TomWhitwell/8mu_Public/Firmware_v2/README.md

## Firmware v2 

Devices bought after August 2026 are v2. They have v2 clearly marked next to the USB socket, and have a RP2040 chip. 

Firmware for v2 will be shared here.
