TomWhitwell/8mu_Public/Hardware/8mu_pub.brd

## EAGLE design Hardware/8mu_pub.brd (2022-12-14, last stored version)

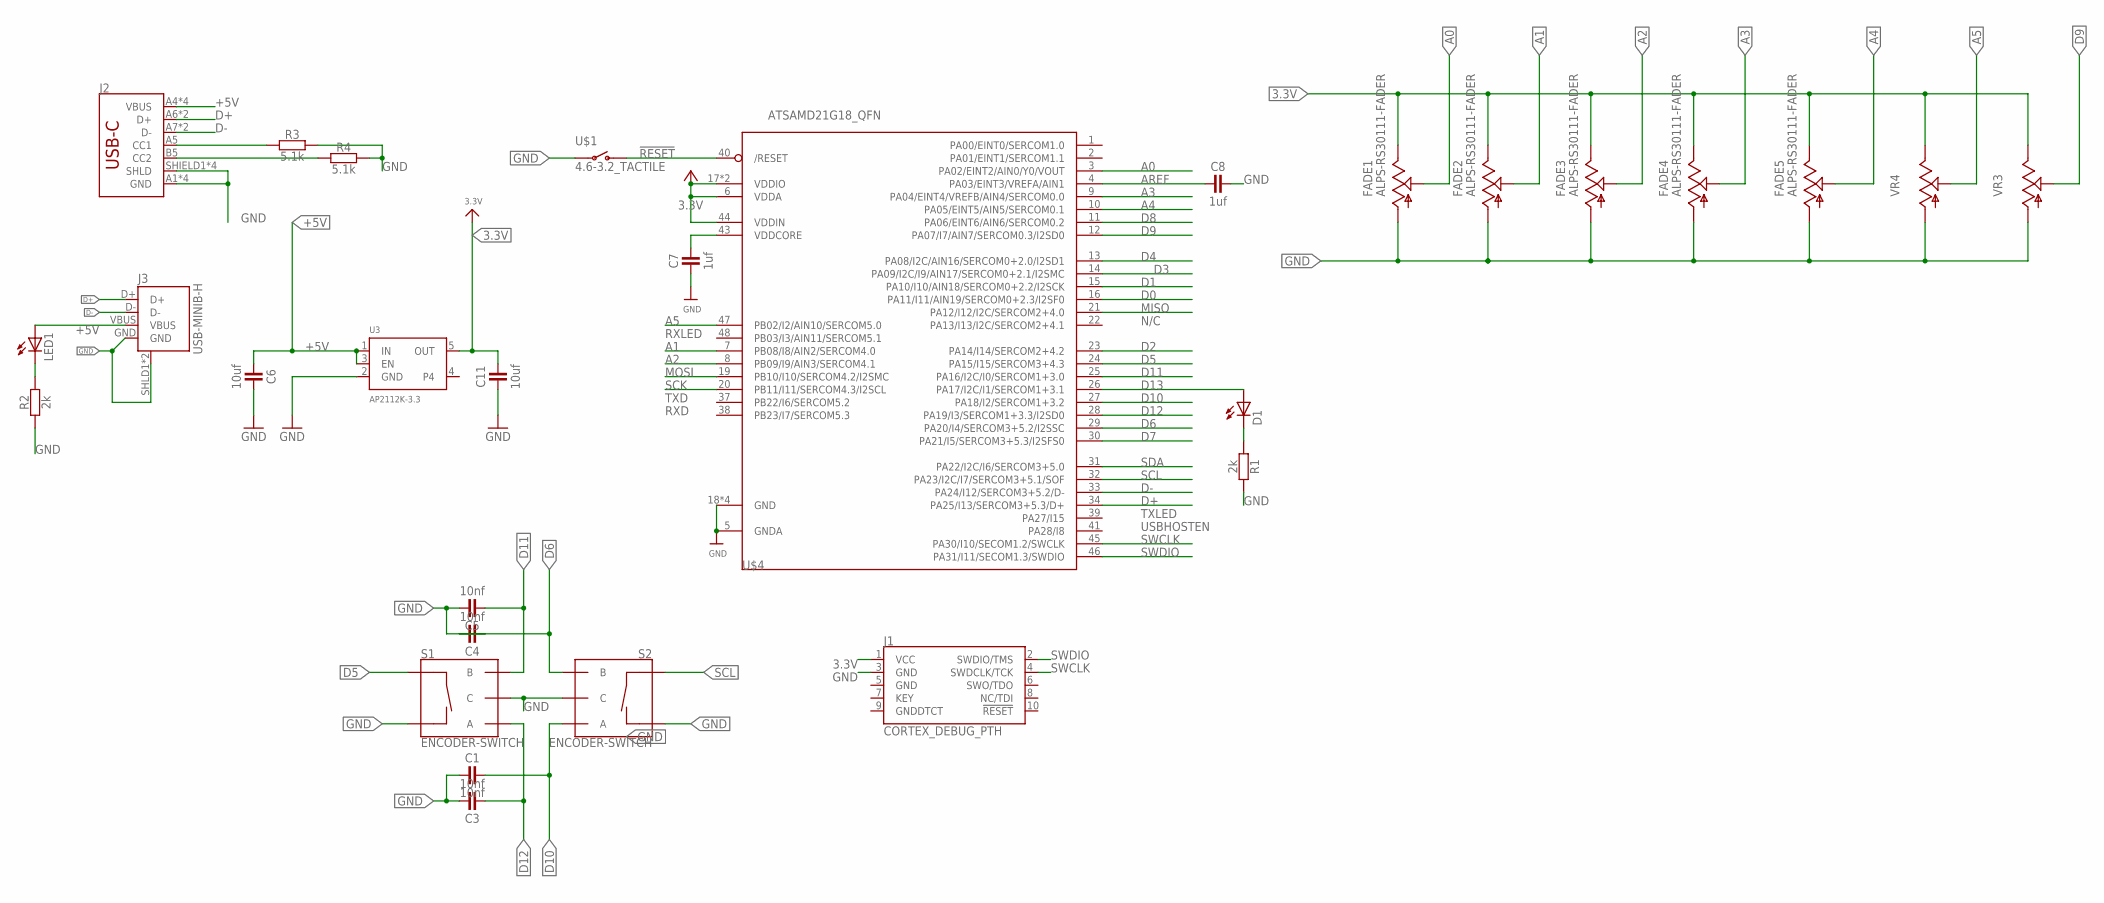
[picture p1: schematic 8mu_pub.sch]

Parts:
C1, C3, C4, C5: 10nf; C0603
C6, C11: 10uf; C0603
C7, C8: 1uf; C0603
D1: LED3MM
FADE1, FADE2, FADE3, FADE4, FADE5: ALPS-RS30111-FADER
J1: CORTEX_DEBUG_PTH; 2X5-PTH-1.27MM
J2: USB_C; CX90M-16P-USB-C-MIDMOUNT
J3: USB-MINIB-H
LED1: LED3MM
R1, R2: 2k; C0603
R3, R4: 5.1k; C0603
S1, S2: ENCODER-SWITCH; ROTARY_ENC_PLAIN
U3: AP2112K-3.3; SOT23-5
U$1: 4.6-3.2_TACTILE; TACTILE_SWITCH_SMD_4.6X2.8MM
U$4: ATSAMD21G18_QFN; TQFN48_7MM
VR3, VR4: 9MM_SNAP-IN_POT_; 9MM_SNAP-IN_POT

Connections:
3.3V: C11.2, FADE1.3 (E), FADE2.3 (E), FADE3.3 (E), FADE4.3 (E), FADE5.3 (E), J1.1 (VCC), U3.5 (OUT), U$4.6 (VDDA), U$4.17 (VDDIO), U$4.36 (VDDIO), U$4.44 (VDDIN), VR3.3 (E), VR4.3 (E)
!RESET: U$1.3 (O), U$1.4 (O), U$4.40 (/RESET)
+5V: C6.1, J2.A4 (VBUS), J2.A9 (VBUS), J2.B4 (VBUS), J2.B9 (VBUS), J3.VBUS, LED1.A, U3.1 (IN), U3.3 (EN)
A0: FADE1.2 (S), U$4.3 (PA02/EINT2/AIN0/Y0/VOUT)
A1: FADE2.2 (S), U$4.7 (PB08/I8/AIN2/SERCOM4.0)
A2: FADE3.2 (S), U$4.8 (PB09/I9/AIN3/SERCOM4.1)
A3: FADE4.2 (S), U$4.9 (PA04/EINT4/VREFB/AIN4/SERCOM0.0)
A4: FADE5.2 (S), U$4.10 (PA05/EINT5/AIN5/SERCOM0.1)
A5: U$4.47 (PB02/I2/AIN10/SERCOM5.0), VR4.2 (S)
AREF: C8.1, U$4.4 (PA03/EINT3/VREFA/AIN1)
D0: U$4.16 (PA11/I11/AIN19/SERCOM0+2.3/I2SF0)
D1: U$4.15 (PA10/I10/AIN18/SERCOM0+2.2/I2SCK)
D2: U$4.23 (PA14/I14/SERCOM2+4.2)
D3: U$4.14 (PA09/I2C/I9/AIN17/SERCOM0+2.1/I2SMC)
D4: U$4.13 (PA08/I2C/AIN16/SERCOM0+2.0/I2SD1)
D5: S1.SW+, U$4.24 (PA15/I15/SERCOM3+4.3)
D6: C4.2, S2.B, U$4.29 (PA20/I4/SERCOM3+5.2/I2SSC)
D7: U$4.30 (PA21/I5/SERCOM3+5.3/I2SFS0)
D8: U$4.11 (PA06/EINT6/AIN6/SERCOM0.2)
D9: U$4.12 (PA07/I7/AIN7/SERCOM0.3/I2SD0), VR3.2 (S)
D10: C1.2, S2.A, U$4.27 (PA18/I2/SERCOM1+3.2)
D11: C5.1, S1.B, U$4.25 (PA16/I2C/I0/SERCOM1+3.0)
D12: C3.1, S1.A, U$4.28 (PA19/I3/SERCOM1+3.3/I2SD0)
D13: D1.A, U$4.26 (PA17/I2C/I1/SERCOM1+3.1)
D+: J2.A6 (D+), J2.B6 (D+), J3.D+, U$4.34 (PA25/I13/SERCOM3+5.3/D+)
D-: J2.A7 (D-), J2.B7 (D-), J3.D-, U$4.33 (PA24/I12/SERCOM3+5.2/D-)
GND: C1.1, C3.2, C4.1, C5.2, C6.2, C7.1, C8.2, C11.1, FADE1.1 (A), FADE2.1 (A), FADE3.1 (A), FADE4.1 (A), FADE5.1 (A), J1.3 (GND), J2.A1 (GND), J2.A12 (GND), J2.B1 (GND), J2.B12 (GND), J2.SHIELD1 (SHLD), J2.SHIELD2 (SHLD), J2.SHIELD3 (SHLD), J2.SHIELD4 (SHLD), J3.GND, J3.SHLD1 (SHIELD), J3.SHLD2 (SHIELD), R1.2, R2.1, R3.2, R4.2, S1.C, S1.SW-, S2.C, S2.SW-, U3.2 (GND), U$1.1, U$1.2, U$4.5 (GNDA), U$4.18 (GND), U$4.35 (GND), U$4.42 (GND), U$4.THERMAL (GND), VR3.1 (A), VR4.1 (A)
MISO: U$4.21 (PA12/I12/I2C/SERCOM2+4.0)
MOSI: U$4.19 (PB10/I10/SERCOM4.2/I2SMC)
unnamed: D1.K (C), R1.1
unnamed: LED1.K (C), R2.2
unnamed: J2.A5 (CC1), R3.1
unnamed: J2.B5 (CC2), R4.1
SCK: U$4.20 (PB11/I11/SERCOM4.3/I2SCL)
SCL: S2.SW+, U$4.32 (PA23/I2C/I7/SERCOM3+5.1/SOF)
SDA: U$4.31 (PA22/I2C/I6/SERCOM3+5.0)
SWCLK: J1.4 (SWDCLK/TCK), U$4.45 (PA30/I10/SECOM1.2/SWCLK)
SWDIO: J1.2 (SWDIO/TMS), U$4.46 (PA31/I11/SECOM1.3/SWDIO)
VDDCORE: C7.2, U$4.43 (VDDCORE)

Notes on the sheet:
N/C
TXLED
USBHOSTEN
RXLED
TXD
RXD

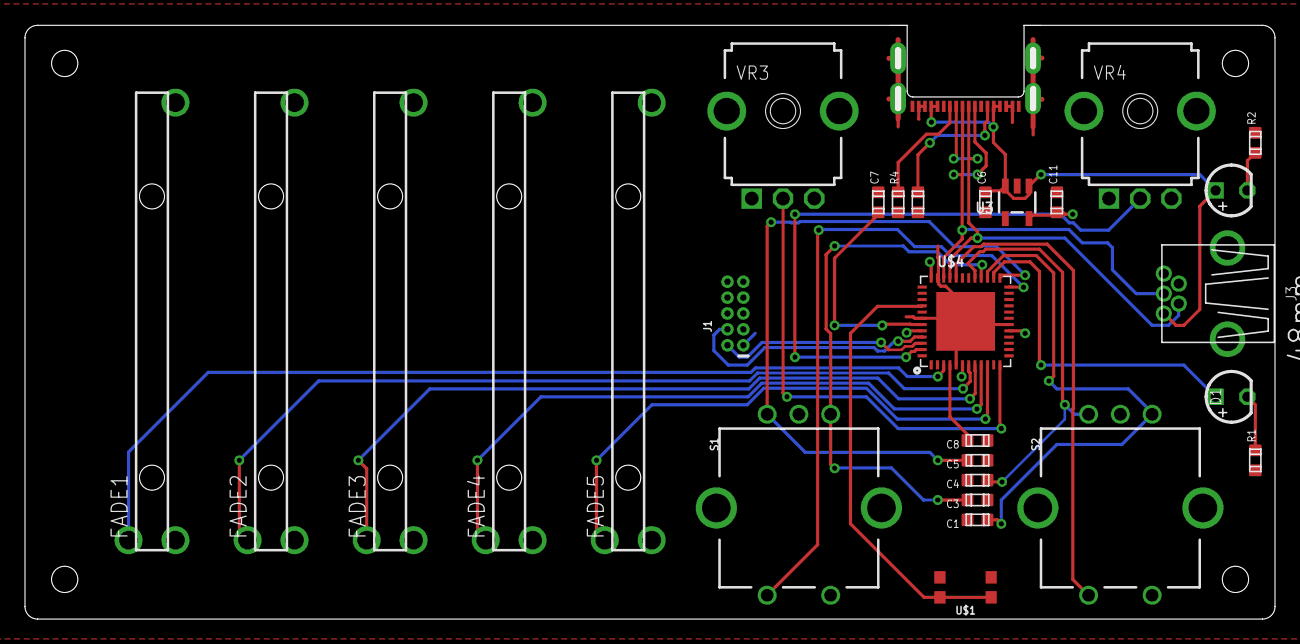
[picture p2: board 8mu_pub.brd from above]

Board: 2 copper layers, 100.0 x 47.5 mm, 29 parts (0 on the bottom side), 28 nets.
