TomWhitwell/8mu_Public/(threads)

Thread 1 (2023-04-22):

Fader Channel stuck on 127

TomWhitwell, 2023-04-22:
This is a are issue, seen normally when a board has been experimented with - multiple different firmware etc.

Symptoms:
* One channel - for example Channel 3 - is stuck on 127.
* Happens randomly, attached to a particular device.
* Multiple firmware & hardware versions, including rev 1 hardware and 1.0.1 firmware
* Just after the firmware is updated by uf2 drop, the channel works as normal, until the device is power-cycled, when the channel sticks.

Insights / attempts to mediate:

Observations
* In the editor, the channel appears normal = it's set to an active channel
* There is no difference in EEPROM file from an effected board and a normal board (checked with diff)
* This is not a simple hardware issue: Evidence: 1) Board works as normal after uf2 added, before power cycle. 2) Board can do normal analogReads in arduino mode with a test sketch.
* The channel LED doesn't light, which is expected because the value never changes from 127

Things tried
* Resetting firmware using ABCD on launch = no difference
* Re-install SAMD21 bootloader after erasing flash = no difference
* Changing calibration settings on analog reads to min=1000 max = 3000 = no difference
* Re-installing arduino firmware = no difference - after the power cycle
* Installing Circuit Python & removing setup files = no difference
* Running storage.erase_filesystem() on Circuit Python to entirely wipe the Flash = no difference
* Add a routine setting all analog channels mode to OUTPUT = no difference
* Add 1000ms delay on startup = no difference

TomWhitwell, 2023-04-22:
Try - check the analogRead process in 8mu.ino

```
  // Read Faders
  for (int j = 0; j < 8; j++) {
    int thisFader = abs((7 * flip) - j);
    analog[j]->update(analogRead(faders[thisFader]));
    int temp = analog[j]->getValue();

    D(Serial.print(j));
    D(Serial.print(" "));
    D(Serial.println(temp));

    temp = constrain(temp, faderMin, faderMax);
    temp = map(temp, faderMin, faderMax, 0, (1 << adcResolutionBits) - 1);
    if (!flip) temp = ((1 << adcResolutionBits) - 1 ) - temp;
    currentValue[j] = temp;
  }
```
Produces this in serial monitor:

```
0 3601
1 3277
2 -2147483648
3 3558
4 3492
5 3046
6 2363
7 2098
```

TomWhitwell, 2023-04-22:
Ensure that analogRead is performing as expected:

```
// Read Faders
  for (int j = 0; j < 8; j++) {
    int thisFader = abs((7 * flip) - j);
    int thisReading = analogRead(faders[thisFader]);
    analog[j]->update(thisReading);
    int temp = analog[j]->getValue();

    D(Serial.print(j));
    D(Serial.print(" "));
    D(Serial.print(thisReading));
    D(Serial.print(" "));
    D(Serial.println(temp));

    temp = constrain(temp, faderMin, faderMax);
    temp = map(temp, faderMin, faderMax, 0, (1 << adcResolutionBits) - 1);
    if (!flip) temp = ((1 << adcResolutionBits) - 1 ) - temp;
    currentValue[j] = temp;
  }
```

```
0 831 858
1 931 958
2 1485 -2147483648
3 2116 2143
4 2505 2531
5 2274 2300
6 2122 2151
7 2274 2298
```

TomWhitwell, 2023-04-22:
ResponsiveAnalogRead is latest version:
https://github.com/dxinteractive/ResponsiveAnalogRead
v1.2.1

TomWhitwell, 2023-04-22:
Check Raw value is correct:

```
 // Read Faders
  for (int j = 0; j < 8; j++) {
    int thisFader = abs((7 * flip) - j);
    int thisReading = analogRead(faders[thisFader]);
    analog[j]->update(thisReading);
    int temp = analog[j]->getValue();
    int tempraw = analog[j]->getRawValue();

    D(Serial.print(j));
    D(Serial.print(" "));
    D(Serial.print(tempraw));
    D(Serial.print(" "));
    D(Serial.println(temp));

    temp = constrain(temp, faderMin, faderMax);
    temp = map(temp, faderMin, faderMax, 0, (1 << adcResolutionBits) - 1);
    if (!flip) temp = ((1 << adcResolutionBits) - 1 ) - temp;
    currentValue[j] = temp;
  }
```

Raw value is correct:

```
0 829 858
1 927 958
2 723 -2147483648
3 2114 2141
4 2502 2529
5 2273 2300
6 2121 2148
7 2276 2298

```

TomWhitwell, 2023-04-23:
Error was caused by responsive analog read library - smoothValue was uninitialised - so in come cases it could start at spurious values rather than zero.
Added a local version of the library with issue corrected
https://github.com/dxinteractive/ResponsiveAnalogRead/issues/34

TomWhitwell, 2023-04-27:
NB this will be resolved in 8mu firmware 1.0.2

Closed 2023-04-23.

Thread 2 (2023-04-23):

Improve smoothing on faders and imu channels

TomWhitwell, 2023-04-23:
Reduce snapMultiplier from 0.001 to 0.0001 = smaller number = more easing
Reduce activity threshold from 32 to 16

```
    analog[i] = new ResponsiveAnalogRead(0, true, .0001);
    analog[i]->setActivityThreshold(4 << (adcResolutionBits - 10));
````

TomWhitwell, 2023-05-06:
NB this will be resolved in 8mu firmware 1.0.2

Closed 2023-04-23.

Thread 4 (2023-04-27):

Editor disconnect/reconnect

user9319062, 2023-04-27:
With the web editor open I am only able to edit for a few seconds before it drops, reconnects, and I lose settings before being able to save them.

Steps to recreate
- Editor > Edit Config
- Change a setting
- Don't click to update, just wait

Observed
The unit disconnects, maddeningly, within about 10 seconds. Saving works if you're quick enough, however you can't change more than maybe 2 settings at once before it dumps them

video: https://drive.google.com/file/d/1fW8w71i0r9V7ep8wCjpk2rD4xhKosvxm/view?usp=share_link (apologies if google still show 360p vid)

In Inspect I can see it's listening in a loop like this:
```
Attached sysex listener to  Music Thing m0 Plus
logger.js:3 Hearbeat requesting config.
logger.js:3 Requesting config over Music Thing m0 Plus
logger.js:3 Hoping to receive on Music Thing m0 Plus
```

Then when it drops, we see this:
```
it's a c0nFig message
logger.js:3 Generating config from Uint8Array(122) [240, 125, 0, 0, 15, 4, 1, 0, 1, 1, 0, 0, 0, 15, 0, 122, 31, 1, 1, 0, 0, 0, 0, 0, 0, 1, 1, 1, 1, 1, 1, 1, 1, 1, 1, 1, 1, 1, 1, 1, 1, 1, 1, 1, 1, 1, 1, 1, 1, 0, 0, 0, 0, 0, 0, 0, 0, 6, 35, 10, 37, 38, 39, 40, 41, 42, 43, 44, 45, 46, 47, 48, 49, 8, 9, 10, 11, 12, 13, 14, 41, 42, 43, 44, 45, 46, 47, 48, 49, 1, 1, 1, 1, 1, 1, 1, 1, 1, 1, 1, …]
logger.js:3 Received config ae {faderBlink: 1, accelBlink: 0, controllerFlip: 0, deviceId: 4, firmwareVersion: '1.0.1', …}
```

This is the same log message (I think) as when you plug it in. However in this case it repeats 15/20 times (this appears instantaneous) before going back to cycling through the `Hearbeat` process again. Additionally, every LED flashes on quickly once (not animated, as when you power it up).  If the editor is closed, there is no activity on the LEDs (until you use it, obviously).

I tried numerous different USB-C cables but it's the same for each. Current workaround is to download the json file and manually edit each before uploading in order to preserve sanity

Tested on Mac OS Monterey, Chrome (latest) & Firefox (latest)

TomWhitwell, 2023-04-27:
Hi, that sounds super frustrating. It's not something I've seen in beta testing. Aside from editing, is the 8mu reliable when sending out MIDI?

Coincidentally I'm about to do a significant update the web editor - moving to v2 to match more recent 16n editor. This should happen in the next few days so will be useful to see if it has any impact - if you email me I can share a beta link.

user9319062, 2023-04-27:
Yes it's reliable I think. I only built it yesterday, but so far so good, getting consistent results from the faders when connected - it's only updating that presents a problem

I still half-suspect it's my USB cables. Even though I've tried 3 different ones, none of them are 'brand new' (but they don't have any problems doing what they're normally used for, ie charging a phone, data transfer to ipad etc.

I'll also try from a different computer when I get the chance. Will email you about that beta!

TomWhitwell, 2023-04-27:
The Editor connects with the 8mu via Midi Sysex messages, so if the cable works as a controller it should work with the editor

TomWhitwell, 2023-04-28:
Solved with forthcoming 2.0 editor - Due before May 2023

Closed 2023-04-28.

Thread 9 (2023-05-23):

USB power sending garbage to Disting EX via TRS output

user9319062, 2023-05-23:
8mu only sends useful data down the MIDI TRS when plugged into my laptop. When I try a mains charger, or a power brick, it sends all sorts of garbage (stop/start messages, channel on/off messages etc) instead of the configured data.

Video: https://drive.google.com/file/d/1BeTq3X8LhMQsimWfP_UUjrc40plyOlWr/view?usp=sharing)
(Disting EX shows all the midi messages it receives.)

Tested the same TRS/wallplug combination with a Volca FM and all the faders worked properly. Also tried it with a crappy 'USB stick with DIN cables sticking out of it' MIDI interface, again powered by plug/mobile charger. All the CCs came in fine, per MidiView (mac).

While the problem is limited to the Disting EX I'mm not sure whether it's an EX problem or an 8mu problem. Made a [post on modwiggler](https://www.modwiggler.com/forum/viewtopic.php?p=3969773#p3969773) to confirm with Expert Sleepers what might be causing the EX to receive data in this way, in case it helps establish what's going on

user9319062, 2023-05-24:
From expert sleepers "I can't explain why the different power sources affect the behaviour, but I did have a look at the 8mu schematic, and its MIDI port doesn't comply with the MIDI electrical standard, which is surprising, and a possible source of error"

One thing i noted today is that it's not really 'garbage' showing up on the EX, it's a consistent interpolation of repeatable messages. The Disting only shows the last 4 items of MIDI history so I can't get a dump of what happens when you slide 1-127, but I manually transcribed a lot of them below, there's definitely some sort of pattern:

**1 - 70**
**Variations on the following, never 100% consistent, eg:**

1 - Ch 1 Off 12 0
2 - Ch 1 Off 3 48
3 - Ch 1 Off 48 12
4 - Ch 1 Off 12 2
...etc

**Then this pattern seems consitent:**

71 - Ch 1 Off 48 12
72 - Ch 2 Off 48 12
73 - Ch 3 Off 48 12
74 - Ch 4 Off 48 12
75 - Ch 5 Off 48 12
76 - Ch 6 Off 48 12
77 - Ch 7 Off 48 12
78 - Ch 8 Off 48 12
79 - Ch 9 Off 48 12
80 - Ch 10 Off 48 12
81 - Ch 11 Off 48 12
82 - Ch 12 Off 48 12
83 - Ch 13 Off 48 12
84 - Ch 14 Off 48 12
85 - Ch 15 Off 48 12
86 - Ch 16 Off 48 12
87 - Ch 1 On 48 12
88 - Ch 2 On 48 12
89 - Ch 3 On 48 12
90 - Ch 4 On 48 12
91 - Ch 5 On 48 12
92 - Ch 6 On 48 12
93 - Ch 7 On 48 12
94 - Ch 8 On 48 12
95 - Ch 9 On 48 12
96 - Ch 10 On 48 12
97 - Ch 11 On 48 12
98 - Ch 12 On 48 12
99 - Ch 13 On 48 12
100 - Ch 14 On 48 12
101 - Ch 15 On 48 12
102 - Ch 16 On 48 12
103 - Ch 1 Bend -6608
104 - Ch 2 Bend -6608
105 - Ch 3 Bend -6608
106 - Ch 4 Bend -6608
107 - Ch 5 Bend -6608
108 - Ch 6 Bend -6608
109 - Ch 7 Bend -6608
110 - Ch 8 Bend -6608
111 - Ch 9 Bend -6608
112 - Ch 10 Bend -6608
113 - Ch 11 Bend -6608
114 - Ch 12 Bend -6608
115 - Ch 13 Bend -6608
116 - Ch 14 Bend -6608
117 - Ch 15 Bend -6608
118 - Ch 16 Bend -6608
119 - SPP
120 - clock
121 - reserved
122 - start
123 - Continue
124 - Stop
125 - reserved
126 - Active Sensing
127 - Reset

In addition, I have a bank where all the accelerometer functions are disabled. When this bank is selected, no so-called 'garbage' is received from accelerometer movements. If I select a bank with CCs assigned to movements, they send out the pattern. So the 8mu is only sending incorrect data from fader/accelerometer movements that have been configured to do so (but the data is incorrect)

expertsleepers, 2023-06-02:
I just tested with an 8mu, a disting EX, and the same PSU you mentioned on Modwiggler

https://www.amazon.co.uk/Huawei-Official-White-SuperCharge-Charger/dp/B07MCY64JD

and it all appears to work fine.

user9319062, 2023-06-08:
Very mysterious. seems to suggest an issue with my particular unit?

I'm out of the country until next week but maybe I should try different wall power or something? Currently I think it's going into a 4-way and then the wall, but I'll have a mess around. If that doesn't work (I don't think it will lol) I can try to reset again, and then reinstall the firmware as well, see if that helps?

I have to say, I was pretty sure I tried these steps initially. The thing is, the further away from the initial discovery I get, the less sure I am!

user9319062, 2023-06-15:
OK, I've tried everything above, with no change in behaviour. Seems very peculiar that i appear to be the only one experiencing this. lucky me 😢

While trying a few things out I did stumble on a workaround for when I want to perform live - the 8mu sends the correct CVs to the EX when connected to my phone (but not a power brick, sadly). This does mean I don't have to take my laptop with me if I want to leave the studio, which is a relief. Better than nothing!

Closed 2023-07-28.

Thread 13 (2024-01-21):

wrong digits when switching to bank 2

bionoid, 2024-01-21:
when switching to bank 2 digits in header of config stay "bank 1", controller setups are switching properly

ConnorMilstead, 2024-07-03:
Seconded. My iteration of this bug doesn't go to bank 2 at all. Just goes straight to 3. When switching back to "bank 2," it just skips and goes to bank 1.

Thread 14 (2024-02-15):

bank 1 misidentified in editor

DaveSeidel, 2024-02-15:
I am currently using banks 1-4. At some point, the editor started displaying "Bank 4" when the device is set to bank 1. This hasn't affected the device configuration, all configured sliders/buttons are properly assigned based on the bank. Also, if I export from the editor, the JSON output contains the expected For example, when I export bank 1, the resulting JSON contains `"pageNumber": 0`, bank 2 has `"pageNumber": 1` and so on. So, this issue doesn't affect functionality, but it is confusing.

Thread 16 (2024-06-16):

note 127 showing up as undefined note in button menu

fmrlwav, 2024-06-16:
every time I set the note value of a button to 127 and save it to the 8mu, it resets to note number 0 (note undefined).  Really would like note 127 to send properly, I'm using with latest sleepy circuits hypno which sends a specific function on that note.

Thread 17 (2024-07-29):

Allow minimum and maximum values for CC messages

levicole, 2024-07-29:
SHIK supports this in their midi controllers. It's kind of a nice added feature where you can set the minimum/max values and the fader then interpolates between those values instead of 0-127.

I might be able to take a stab at this as well if it's something you think is worth adding to the firmware. I should be able to do the firmware and UI work.

TomWhitwell, 2024-07-29:
Hi thank you for the message - can't I normally do this in the host? I think I can do it Ableton.
It's very useful for things like DX7 sysex messages (which 8mu can't send at the moment), but I wouldn't say it was a priority for me.

levicole, 2024-07-29:
I'll have to check, but for the devices I'm thinking about this for (Digitakt mostly) I don't believe I can.

TomWhitwell, 2024-07-30:
OK that's interesting- is there anything else that might be useful on those Elektron boxes? - someone told me "the thing that would make the biggest difference and open up lots of fun with Elektron gear would be adding program changes"

Also maybe quantising ccs in some way as well as scaling? I don't really know what that would mean!

I don't have any experience with Elektron so it's a bit of a blind spot.

levicole, 2024-07-31:
Oh, interesting. Sending program changes? or receiving them?

Macros are another thing I think would be interesting. Macros meaning, being able send two CC's from the same fader/button.

TomWhitwell, 2024-07-31:
I don't really know - what's useful in Elektron world?

levicole, 2024-07-31:
I could see it being helpful both ways, honestly. But I'd bet the person you spoke with wanted to be able to change banks on the 8MU as banks change on their Elektron device, which would only be possible with a USB midi host somewhere in the chain since there is no midi TRS into 8mu.

I'll fork the repo and see what I can come up with that might be fun.

How much EEPROM is available?

Thread 20 (2025-04-24):

Excessive EEPROM write?

fuzboxz, 2025-04-24:
It seems to me that every time a page is switched the firmware writes the current page settings into the EEPROM. I might be mistaken, but wouldn't the page settings change only when sysex is received? Given that configuration changes are already saved when the sysex is received the BANK_STORE.write(0, page); line seems redundant.
https://github.com/TomWhitwell/8mu_Public/blob/35bced77bafbde008758cebd4096d3fc9848923e/Firmware/8mu/utils.ino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

Am I missing something or could this be removed to reduce the number of EEPROM write operations?

TomWhitwell, 2025-04-24:
It has to remember which back is currently active - that's why there's a write every time
