TomWhitwell/8mu_Public/(commit log)

2022-12-14 initial files
    [8mu_pub.brd, 8mu_pub.sch]
2023-03-07 Remove placeholder files
    [8mu_pub.brd, 8mu_pub.sch]
2023-04-18 Update device options.
2023-04-23 v1.0.2 Fixes #1 and improves smoothing of fader channels and more aggressive smoothing on IMU channels
    [8mu.ino]
2023-05-08 v1.0.2 firmware code fixes #8 fixes #2 fixes #1
    [8mu.ino, uMidi.cpp]
